Superscalar-HIT-Core/SHIT-Core-NSCSCC2020/src/rtl/CtrlUnitBackend.sv

`timescale 1ns / 1ps
`include "defines/defines.svh"

module CtrlUnitBackend(
    input clk,
    input rst,
    Ctrl.master     backend_ctrl,

    Ctrl.master     ctrl_instBuffer_decode_regs,
    Ctrl.master     ctrl_decode_rename_regs,
    Ctrl.master     ctrl_rob,
    Ctrl.master     ctrl_issue_alu0_regs,
    Ctrl.master     ctrl_issue_alu1_regs,
    Ctrl.master     ctrl_issue_mdu_regs,
    Ctrl.master     ctrl_issue_lsu_regs,
    Ctrl.master     ctrl_rf_alu0_regs,
    Ctrl.master     ctrl_rf_alu1_regs,
    Ctrl.master     ctrl_rf_mdu_regs,
    Ctrl.master     ctrl_rf_lsu_regs,
    Ctrl.master     ctrl_lsu,
    Ctrl.master     ctrl_mdu,
    Ctrl.master     ctrl_alu0_output_regs,
    Ctrl.master     ctrl_alu1_output_regs,
    Ctrl.master     ctrl_mdu_output_regs,
    Ctrl.master     ctrl_lsu_output_regs,
    Ctrl.master     ctrl_commit,

    input wire           aluIQReady,
    input wire           lsuIQReady,
    input wire           mduIQReady,
    input wire           renameAllocatable,
    input wire           dispatch_pause_req,

    output wire           renameRecover,
    output wire           aluIQFlush,
    output wire           lsuIQFlush,
    output wire           mduIQFlush,

    output wire           pauseRename,
    output wire           pauseRename_dispatch_reg,
    output wire           pauseDispatch_iq_reg,
    output wire           pauseDispatch
);

    assign ctrl_instBuffer_decode_regs.pause =
        ctrl_rob.pauseReq                   ||
        ctrl_decode_rename_regs.pauseReq    ||
        !aluIQReady                         ||
        !lsuIQReady                         ||
        !mduIQReady                         ||
        !renameAllocatable                  ||
        dispatch_pause_req;

    assign ctrl_decode_rename_regs.pause =
        ctrl_rob.pauseReq                   ||
        !aluIQReady                         ||
        !lsuIQReady                         ||
        !mduIQReady                         ||
        !renameAllocatable                  ||
        dispatch_pause_req;

    assign pauseRename =
        ctrl_rob.pauseReq                   ||
        !aluIQReady                         ||
        !lsuIQReady                         ||
        !mduIQReady                         ||
        dispatch_pause_req;

    assign pauseRename_dispatch_reg =
        ctrl_rob.pauseReq                   ||
        !aluIQReady                         ||
        !lsuIQReady                         ||
        !mduIQReady                         ||
        dispatch_pause_req;

    assign pauseDispatch =
        ctrl_rob.pauseReq                   ||
        !aluIQReady                         ||
        !lsuIQReady                         ||
        !mduIQReady;

    assign pauseDispatch_iq_reg = 
        !aluIQReady                         ||
        !lsuIQReady                         ||
        !mduIQReady;
    
    reg flushReq_dly;
    always @(posedge clk)   begin
        if(rst) begin
            flushReq_dly <= 0;
        end else begin
            flushReq_dly <= ctrl_commit.flushReq;
        end
    end
    assign  ctrl_instBuffer_decode_regs.flush   = flushReq_dly;
    assign  ctrl_decode_rename_regs.flush       = flushReq_dly;
    assign  ctrl_rob.flush                      = flushReq_dly || ctrl_commit.flushReq;
    assign  ctrl_issue_alu0_regs.flush          = flushReq_dly;
    assign  ctrl_issue_alu1_regs.flush          = flushReq_dly;
    assign  ctrl_issue_lsu_regs.flush           = flushReq_dly;
    assign  ctrl_issue_mdu_regs.flush           = flushReq_dly;
    assign  ctrl_rf_alu0_regs.flush             = flushReq_dly;
    assign  ctrl_rf_alu1_regs.flush             = flushReq_dly;
    assign  ctrl_rf_mdu_regs.flush              = flushReq_dly;
    assign  ctrl_rf_lsu_regs.flush              = flushReq_dly;
    assign  ctrl_alu0_output_regs.flush         = flushReq_dly;
    assign  ctrl_alu1_output_regs.flush         = flushReq_dly;
    assign  ctrl_mdu_output_regs.flush          = flushReq_dly;
    assign  ctrl_mdu.flush                      = flushReq_dly;
    assign  ctrl_lsu_output_regs.flush          = flushReq_dly;
    assign  ctrl_lsu.flush                      = flushReq_dly || ctrl_commit.flushReq;
    assign  aluIQFlush                          = flushReq_dly;
    assign  lsuIQFlush                          = flushReq_dly;
    assign  mduIQFlush                          = flushReq_dly;
    assign  backend_ctrl.flush                  = ctrl_commit.flushReq;
    assign  renameRecover                       = flushReq_dly;
    assign  backend_ctrl.pause                  = `FALSE;

endmodule
