Superscalar-HIT-Core/SHIT-Core-NSCSCC2020/src/rtl/decode.sv

`timescale 1ns / 1ps
`include "defines/defines.svh"


module decode(
    Regs_Decode.decode  regs_decode,
    Decode_Regs.decode  decode_regs
);
    logic   [ 5:0]  opcode;
    logic   [ 5:0]  rs;
    logic   [ 5:0]  rt;
    logic   [ 5:0]  rd;
    logic   [ 5:0]  funct;
    logic   [31:0]  imm;
    logic   [31:0]  imm2;
    logic   [31:0]  imm_ze;
    logic   [31:0]  imm_lui;
    logic   [25:0]  address;
    logic   [31:0]  inst_raw;
    InstBundle      inst;
    UOPBundle       uOP0, uOP1;

    
    assign decode_regs.uOP0 = uOP0;
    assign decode_regs.uOP1 = uOP1;


    assign inst     = regs_decode.inst;
    assign inst_raw = regs_decode.inst.inst;
    assign opcode   = inst_raw[31:26];
    assign rs       = {1'b0, inst_raw[25:21]};
    assign rt       = {1'b0, inst_raw[20:16]};
    assign rd       = {1'b0, inst_raw[15:11]};
    assign funct    = inst_raw[5: 0];
    assign imm      = {{16{inst_raw[15]}}, inst_raw[15: 0]};
    assign imm_ze   = {{16'h0000}, inst_raw[15: 0]};
    assign imm2     = {27'h0, inst_raw[10: 6]};
    assign imm_lui  = { inst_raw[15:0] , 16'b0 };
    assign address  = inst_raw[25: 0];
    // regs_decode.inst: InstBundle

    always_comb begin
        uOP0             = 0;
        uOP1             = 0;
        uOP0.uOP         = NOP_U;
        uOP0.nlpBimState = inst.nlpInfo.valid ? inst.nlpInfo.bimState : 2'b01;
        uOP1.uOP         = NOP_U;
        uOP0.pc          = inst.pc;
        uOP0.predTaken   = inst.predTaken;
        uOP0.predAddr    = inst.predAddr;
        uOP0.predInfo    = inst.bpdInfo;
        uOP0.isDS        = inst.isDs;
        uOP0.committed   = `FALSE;
        uOP1.pc          = inst.pc;
        uOP1.isDS        = inst.isDs;
        uOP1.committed   = `FALSE;
        if(inst.valid) begin
            uOP0.isPriv     = `FALSE;
            uOP0.branchType = typeNormal;
            uOP0.imm        = imm;
            uOP0.valid      = `TRUE;
            uOP1.valid      = `FALSE;
            uOP0.causeExc   = `FALSE;
            priority casez(inst_raw)
                `NOP: begin
                    uOP0.valid      = `FALSE;
                end
                `ADD: begin
                    uOP0.uOP        = ADD_U;
                    uOP0.rs_type    = RS_ALU;
                    uOP0.aluType    = ALU_ARITH;
                    uOP0.op0LAddr   = rs;
                    uOP0.op1LAddr   = rt;
                    uOP0.dstLAddr   = rd;
                    uOP0.op0re      = `TRUE;
                    uOP0.op1re      = `TRUE;
                    uOP0.dstwe      = `TRUE;
                end
                `ADDU: begin
                    uOP0.uOP        = ADDU_U;
                    uOP0.rs_type    = RS_ALU;
                    uOP0.aluType    = ALU_ARITH;
                    uOP0.op0LAddr   = rs;
                    uOP0.op1LAddr   = rt;
                    uOP0.dstLAddr   = rd;
                    uOP0.op0re      = `TRUE;
                    uOP0.op1re      = `TRUE;
                    uOP0.dstwe      = `TRUE;
                end
                `ADDI: begin
                    uOP0.uOP        = ADDI_U;
                    uOP0.rs_type    = RS_ALU;
                    uOP0.aluType    = ALU_ARITH;
                    uOP0.op0LAddr   = rs;
                    uOP0.dstLAddr   = rt;
                    uOP0.op0re      = `TRUE;
                    uOP0.op1re      = `FALSE;
                    uOP0.dstwe      = `TRUE;
                end
                `ADDIU: begin
                    uOP0.uOP        = ADDIU_U;
                    uOP0.rs_type    = RS_ALU;
                    uOP0.aluType    = ALU_ARITH;
                    uOP0.op0LAddr   = rs;
                    uOP0.dstLAddr   = rt;
                    uOP0.op0re      = `TRUE;
                    uOP0.op1re      = `FALSE;
                    uOP0.dstwe      = `TRUE;
                end
                `SUB: begin
                    uOP0.uOP        = SUB_U;
                    uOP0.rs_type    = RS_ALU;
                    uOP0.aluType    = ALU_ARITH;
                    uOP0.op0LAddr   = rs;
                    uOP0.op1LAddr   = rt;
                    uOP0.dstLAddr   = rd;
                    uOP0.op0re      = `TRUE;
                    uOP0.op1re      = `TRUE;
                    uOP0.dstwe      = `TRUE;
                end
                `SUBU: begin
                    uOP0.uOP        = SUBU_U;
                    uOP0.rs_type    = RS_ALU;
                    uOP0.aluType    = ALU_ARITH;
                    uOP0.op0LAddr   = rs;
                    uOP0.op1LAddr   = rt;
                    uOP0.dstLAddr   = rd;
                    uOP0.op0re      = `TRUE;
                    uOP0.op1re      = `TRUE;
                    uOP0.dstwe      = `TRUE;
                end
                `SLT: begin
                    uOP0.uOP        = SLT_U;
                    uOP0.rs_type    = RS_ALU;
                    uOP0.aluType    = ALU_ARITH;
                    uOP0.op0LAddr   = rs;
                    uOP0.op1LAddr   = rt;
                    uOP0.dstLAddr   = rd;
                    uOP0.op0re      = `TRUE;
                    uOP0.op1re      = `TRUE;
                    uOP0.dstwe      = `TRUE;
                end
                `SLTU: begin
                    uOP0.uOP        = SLTU_U;
                    uOP0.rs_type    = RS_ALU;
                    uOP0.aluType    = ALU_ARITH;
                    uOP0.op0LAddr   = rs;
                    uOP0.op1LAddr   = rt;
                    uOP0.dstLAddr   = rd;
                    uOP0.op0re      = `TRUE;
                    uOP0.op1re      = `TRUE;
                    uOP0.dstwe      = `TRUE;
                end
                `SLTI: begin
                    uOP0.uOP        = SLTI_U;
                    uOP0.rs_type    = RS_ALU;
                    uOP0.aluType    = ALU_ARITH;
                    uOP0.op0LAddr   = rs;
                    uOP0.dstLAddr   = rt;
                    uOP0.op0re      = `TRUE;
                    uOP0.op1re      = `FALSE;
                    uOP0.dstwe      = `TRUE;
                end
                `SLTIU: begin
                    uOP0.uOP        = SLTIU_U;
                    uOP0.rs_type    = RS_ALU;
                    uOP0.aluType    = ALU_ARITH;
                    uOP0.op0LAddr   = rs;
                    uOP0.dstLAddr   = rt;
                    uOP0.op0re      = `TRUE;
                    uOP0.op1re      = `FALSE;
                    uOP0.dstwe      = `TRUE;
                end
                `DIV: begin
                    uOP0.uOP        = DIVHI_U;
                    uOP0.rs_type    = RS_MDU;
                    uOP0.op0LAddr   = rs;
                    uOP0.op1LAddr   = rt;
                    uOP0.dstLAddr   = `REGHI;
                    uOP0.op0re      = `TRUE;
                    uOP0.op1re      = `TRUE;
                    uOP0.dstwe      = `TRUE;

                    uOP1.uOP        = DIVLO_U;
                    uOP1.rs_type    = RS_MDU;
                    uOP1.op0LAddr   = rs;
                    uOP1.op1LAddr   = rt;
                    uOP1.dstLAddr   = `REGLO;
                    uOP1.op0re      = `TRUE;
                    uOP1.op1re      = `TRUE;
                    uOP1.dstwe      = `TRUE;
                    uOP1.valid      = `TRUE;
                end
                `DIVU: begin
                    uOP0.uOP        = DIVUHI_U;
                    uOP0.rs_type    = RS_MDU;
                    uOP0.op0LAddr   = rs;
                    uOP0.op1LAddr   = rt;
                    uOP0.dstLAddr   = `REGHI;
                    uOP0.op0re      = `TRUE;
                    uOP0.op1re      = `TRUE;
                    uOP0.dstwe      = `TRUE;

                    uOP1.uOP        = DIVULO_U;
                    uOP1.rs_type    = RS_MDU;
                    uOP1.op0LAddr   = rs;
                    uOP1.op1LAddr   = rt;
                    uOP1.dstLAddr   = `REGLO;
                    uOP1.op0re      = `TRUE;
                    uOP1.op1re      = `TRUE;
                    uOP1.dstwe      = `TRUE;
                    uOP1.valid      = `TRUE;
                end
                `MULT: begin
                    uOP0.uOP        = MULTHI_U;
                    uOP0.rs_type    = RS_MDU;
                    uOP0.op0LAddr   = rs;
                    uOP0.op1LAddr   = rt;
                    uOP0.dstLAddr   = `REGHI;
                    uOP0.op0re      = `TRUE;
                    uOP0.op1re      = `TRUE;
                    uOP0.dstwe      = `TRUE;

                    uOP1.uOP        = MULTLO_U;
                    uOP1.rs_type    = RS_MDU;
                    uOP1.op0LAddr   = rs;
                    uOP1.op1LAddr   = rt;
                    uOP1.dstLAddr   = `REGLO;
                    uOP1.op0re      = `TRUE;
                    uOP1.op1re      = `TRUE;
                    uOP1.dstwe      = `TRUE;
                    uOP1.valid      = `TRUE;
                end
                `MULTU: begin
                    uOP0.uOP        = MULTUHI_U;
                    uOP0.rs_type    = RS_MDU;
                    uOP0.op0LAddr   = rs;
                    uOP0.op1LAddr   = rt;
                    uOP0.dstLAddr   = `REGHI;
                    uOP0.op0re      = `TRUE;
                    uOP0.op1re      = `TRUE;
                    uOP0.dstwe      = `TRUE;

                    uOP1.uOP        = MULTULO_U;
                    uOP1.rs_type    = RS_MDU;
                    uOP1.op0LAddr   = rs;
                    uOP1.op1LAddr   = rt;
                    uOP1.dstLAddr   = `REGLO;
                    uOP1.op0re      = `TRUE;
                    uOP1.op1re      = `TRUE;
                    uOP1.dstwe      = `TRUE;
                    uOP1.valid      = `TRUE;
                end
                `MUL: begin
                    uOP0.uOP        = MULTHI_U;
                    uOP0.rs_type    = RS_MDU;
                    uOP0.op0LAddr   = rs;
                    uOP0.op1LAddr   = rt;
                    uOP0.dstLAddr   = 0;    // discard high 32
                    uOP0.op0re      = `TRUE;
                    uOP0.op1re      = `TRUE;
                    uOP0.dstwe      = `FALSE;

                    uOP1.uOP        = MULTLO_U;
                    uOP1.rs_type    = RS_MDU;
                    uOP1.op0LAddr   = rs;
                    uOP1.op1LAddr   = rt;
                    uOP1.dstLAddr   = rd;
                    uOP1.op0re      = `TRUE;
                    uOP1.op1re      = `TRUE;
                    uOP1.dstwe      = `TRUE;
                    uOP1.valid      = `TRUE;
                end
                `AND: begin
                    uOP0.uOP        = AND_U;
                    uOP0.rs_type    = RS_ALU;
                    uOP0.aluType    = ALU_LOGIC;
                    uOP0.op0LAddr   = rs;
                    uOP0.op1LAddr   = rt;
                    uOP0.dstLAddr   = rd;
                    uOP0.op0re      = `TRUE;
                    uOP0.op1re      = `TRUE;
                    uOP0.dstwe      = `TRUE;
                end
                `ANDI: begin
                    uOP0.uOP        = ANDI_U;
                    uOP0.rs_type    = RS_ALU;
                    uOP0.aluType    = ALU_LOGIC;
                    uOP0.op0LAddr   = rs;
                    uOP0.dstLAddr   = rt;
                    uOP0.op0re      = `TRUE;
                    uOP0.op1re      = `FALSE;
                    uOP0.dstwe      = `TRUE;
                    uOP0.imm        = imm_ze;
                end
                `OR: begin
                    uOP0.uOP        = OR_U;
                    uOP0.rs_type    = RS_ALU;
                    uOP0.aluType    = ALU_LOGIC;
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
                    uOP0.isPriv     = `TRUE;
                    uOP0.cp0Addr    = rd;
                    uOP0.cp0Sel     = inst[2:0];
                end
                `MTC0: begin
                    uOP0.uOP        = MTC0_U;
                    uOP0.rs_type    = RS_ALU;
                    uOP0.aluType    = ALU_CP0;
                    uOP0.op0LAddr   = rt;
                    uOP0.op0re      = `TRUE;
                    uOP0.op1re      = `FALSE;
                    uOP0.dstwe      = `FALSE;
                    uOP0.isPriv     = `TRUE;
                    uOP0.cp0Addr    = rd;
                    uOP0.cp0Sel     = inst[2:0];
                end
                `TLBP: begin
                    uOP0.uOP        = TLBP_U;
                    uOP0.rs_type    = RS_ALU;
                    uOP0.aluType    = ALU_MISC;
                    uOP0.op0re      = `FALSE;
                    uOP0.op1re      = `FALSE;
                    uOP0.dstwe      = `FALSE;
                    uOP0.isPriv     = `TRUE;
                    uOP0.cp0Addr    = `CP0INDEX;
                end
                `TLBWI: begin
                    uOP0.uOP        = TLBP_U;
                    uOP0.rs_type    = RS_ALU;
                    uOP0.aluType    = ALU_MISC;
                    uOP0.op0re      = `FALSE;
                    uOP0.op1re      = `FALSE;
                    uOP0.dstwe      = `FALSE;
                    uOP0.isPriv     = `TRUE;
                    // use multiple cp0 reg (EntryHi, EntryLo0, EntryLo1)
                end
                `CACHE: begin
                    uOP0.uOP        = CACHE_U;
                    uOP0.rs_type    = RS_ALU;
                    uOP0.aluType    = ALU_MISC;
                    uOP0.op0LAddr   = rs;
                    uOP0.op0re      = `TRUE;
                    uOP0.op1re      = `FALSE;
                    uOP0.dstwe      = `FALSE;
                    uOP0.cacheOP    = inst[16:10];
                end
                `WAIT: begin    // must be priv
                    uOP0.uOP        = WAIT_U;
                    uOP0.rs_type    = RS_ALU;
                    uOP0.aluType    = ALU_MISC;
                    uOP0.op0re      = `FALSE;
                    uOP0.op1re      = `FALSE;
                    uOP0.dstwe      = `FALSE;
                    uOP0.isPriv     = `TRUE;
                end
                default: begin
                    uOP0.uOP        = RESERVED_U;
                    uOP0.rs_type    = RS_ALU;
                    uOP0.aluType    = ALU_MISC;
                    uOP0.op0re      = `FALSE;
                    uOP0.op1re      = `FALSE;
                    uOP0.dstwe      = `FALSE;
                    uOP0.busy       = `FALSE;
                    uOP0.valid      = `TRUE;
                    uOP0.causeExc   = `TRUE;
                    uOP0.exception  = ExcReservedInst;
                end
            endcase
            // inst fetch bad vaddr, high priority
            if(inst.jBadAddr) begin
                uOP0.causeExc       = `TRUE;
                uOP0.exception      = ExcAddressErrIF;
                uOP0.BadVAddr       = inst.predAddr;    // wont trigger on Jr, only when predecode get wrong addr
            end
        end else begin
            uOP0.valid      = `FALSE;
            uOP1.valid      = `FALSE;
        end
    end

endmodule
