Superscalar-HIT-Core/SHIT-Core-NSCSCC2020/src/rtl/exu/prf.sv

`timescale 1ns / 1ps
`include "../defines/defines.svh"
//////////////////////////////////////////////////////////////////////////////////
// 物理寄存器堆文件
//////////////////////////////////////////////////////////////////////////////////

module prf(
    input clk,
    input rst,
    input PRFrNums rnum_ALU_0, rnum_ALU_1, rnum_MDU, rnum_LSU,
    output PRFrData rdata_ALU_0, rdata_ALU_1, rdata_MDU, rdata_LSU,
    input PRFwInfo wb_ALU_0, wb_ALU_1, wb_MDU, wb_LSU
    );
// 4 Banks of prf
reg [31:0] prfs_bank0[63:0];
reg [31:0] prfs_bank1[63:0];
reg [31:0] prfs_bank2[63:0];
reg [31:0] prfs_bank3[63:0];



// Implement Bypass logic
assign rdata_ALU_0.rs0_data =   ( rnum_ALU_0.rs0 == 0 ) ? 32'b0 : 
                                ( (rnum_ALU_0.rs0 == wb_ALU_0.rd) && wb_ALU_0.wen) ? wb_ALU_0.wdata :
                                ( (rnum_ALU_0.rs0 == wb_ALU_1.rd) && wb_ALU_1.wen) ? wb_ALU_1.wdata :
                                ( (rnum_ALU_0.rs0 == wb_MDU.rd) && wb_MDU.wen) ? wb_MDU.wdata :
                                ( (rnum_ALU_0.rs0 == wb_LSU.rd) && wb_LSU.wen) ? wb_LSU.wdata : prfs_bank0[rnum_ALU_0.rs0];

assign rdata_ALU_0.rs1_data =   ( rnum_ALU_0.rs1 == 0 ) ? 32'b0 : 
                                ( (rnum_ALU_0.rs1 == wb_ALU_0.rd) && wb_ALU_0.wen) ? wb_ALU_0.wdata :
                                ( (rnum_ALU_0.rs1 == wb_ALU_1.rd) && wb_ALU_1.wen) ? wb_ALU_1.wdata :
                                ( (rnum_ALU_0.rs1 == wb_MDU.rd) && wb_MDU.wen) ? wb_MDU.wdata :
                                ( (rnum_ALU_0.rs1 == wb_LSU.rd) && wb_LSU.wen) ? wb_LSU.wdata : prfs_bank0[rnum_ALU_0.rs1];

assign rdata_ALU_1.rs0_data =   ( rnum_ALU_1.rs0 == 0 ) ? 32'b0 : 
                                ( (rnum_ALU_1.rs0 == wb_ALU_0.rd) && wb_ALU_0.wen) ? wb_ALU_0.wdata :
                                ( (rnum_ALU_1.rs0 == wb_ALU_1.rd) && wb_ALU_1.wen) ? wb_ALU_1.wdata :
                                ( (rnum_ALU_1.rs0 == wb_MDU.rd) && wb_MDU.wen) ? wb_MDU.wdata :
                                ( (rnum_ALU_1.rs0 == wb_LSU.rd) && wb_LSU.wen) ? wb_LSU.wdata : prfs_bank1[rnum_ALU_1.rs0];

assign rdata_ALU_1.rs1_data =   ( rnum_ALU_1.rs1 == 0 ) ? 32'b0 : 
                                ( (rnum_ALU_1.rs1 == wb_ALU_0.rd) && wb_ALU_0.wen) ? wb_ALU_0.wdata :
                                ( (rnum_ALU_1.rs1 == wb_ALU_1.rd) && wb_ALU_1.wen) ? wb_ALU_1.wdata :
                                ( (rnum_ALU_1.rs1 == wb_MDU.rd) && wb_MDU.wen) ? wb_MDU.wdata :
                                ( (rnum_ALU_1.rs1 == wb_LSU.rd) && wb_LSU.wen) ? wb_LSU.wdata : prfs_bank1[rnum_ALU_1.rs1];

assign rdata_MDU.rs0_data =     ( rnum_MDU.rs0 == 0 ) ? 32'b0 : 
                                ( (rnum_MDU.rs0 == wb_ALU_0.rd) && wb_ALU_0.wen) ? wb_ALU_0.wdata :
                                ( (rnum_MDU.rs0 == wb_ALU_1.rd) && wb_ALU_1.wen) ? wb_ALU_1.wdata :
                                ( (rnum_MDU.rs0 == wb_MDU.rd) && wb_MDU.wen) ? wb_MDU.wdata :
                                ( (rnum_MDU.rs0 == wb_LSU.rd) && wb_LSU.wen) ? wb_LSU.wdata : prfs_bank2[rnum_MDU.rs0];

assign rdata_MDU.rs1_data =     ( rnum_MDU.rs1 == 0 ) ? 32'b0 : 
                                ( (rnum_MDU.rs1 == wb_ALU_0.rd) && wb_ALU_0.wen) ? wb_ALU_0.wdata :
                                ( (rnum_MDU.rs1 == wb_ALU_1.rd) && wb_ALU_1.wen) ? wb_ALU_1.wdata :
                                ( (rnum_MDU.rs1 == wb_MDU.rd) && wb_MDU.wen) ? wb_MDU.wdata :
                                ( (rnum_MDU.rs1 == wb_LSU.rd) && wb_LSU.wen) ? wb_LSU.wdata : prfs_bank2[rnum_MDU.rs1];

assign rdata_LSU.rs0_data =     ( rnum_LSU.rs0 == 0 ) ? 32'b0 : 
                                ( (rnum_LSU.rs0 == wb_ALU_0.rd) && wb_ALU_0.wen) ? wb_ALU_0.wdata :
                                ( (rnum_LSU.rs0 == wb_ALU_1.rd) && wb_ALU_1.wen) ? wb_ALU_1.wdata :
                                ( (rnum_LSU.rs0 == wb_MDU.rd) && wb_MDU.wen) ? wb_MDU.wdata :
                                ( (rnum_LSU.rs0 == wb_LSU.rd) && wb_LSU.wen) ? wb_LSU.wdata : prfs_bank3[rnum_LSU.rs0];

assign rdata_LSU.rs1_data =     ( rnum_LSU.rs1 == 0 ) ? 32'b0 : 
                                ( (rnum_LSU.rs1 == wb_ALU_0.rd) && wb_ALU_0.wen) ? wb_ALU_0.wdata :
                                ( (rnum_LSU.rs1 == wb_ALU_1.rd) && wb_ALU_1.wen) ? wb_ALU_1.wdata :
                                ( (rnum_LSU.rs1 == wb_MDU.rd) && wb_MDU.wen) ? wb_MDU.wdata :
                                ( (rnum_LSU.rs1 == wb_LSU.rd) && wb_LSU.wen) ? wb_LSU.wdata : prfs_bank3[rnum_LSU.rs1];


integer i;
always_ff @(posedge clk)    begin
    if(rst) begin
        for(i=0;i<64;i++)   begin
            prfs_bank0[i] <= 32'b0;
            prfs_bank1[i] <= 32'b0;
            prfs_bank2[i] <= 32'b0;
            prfs_bank3[i] <= 32'b0;
        end
    end else begin
        if(wb_ALU_0.wen) begin
            prfs_bank0[wb_ALU_0.rd] <= wb_ALU_0.wdata;
            prfs_bank1[wb_ALU_0.rd] <= wb_ALU_0.wdata;
            prfs_bank2[wb_ALU_0.rd] <= wb_ALU_0.wdata;
            prfs_bank3[wb_ALU_0.rd] <= wb_ALU_0.wdata;
        end
        if(wb_ALU_1.wen) begin
            prfs_bank0[wb_ALU_1.rd] <= wb_ALU_1.wdata;
            prfs_bank1[wb_ALU_1.rd] <= wb_ALU_1.wdata;
            prfs_bank2[wb_ALU_1.rd] <= wb_ALU_1.wdata;
            prfs_bank3[wb_ALU_1.rd] <= wb_ALU_1.wdata;
        end
        if(wb_MDU.wen) begin
            prfs_bank0[wb_MDU.rd] <= wb_MDU.wdata;
            prfs_bank1[wb_MDU.rd] <= wb_MDU.wdata;
            prfs_bank2[wb_MDU.rd] <= wb_MDU.wdata;
            prfs_bank3[wb_MDU.rd] <= wb_MDU.wdata;
        end
        if(wb_LSU.wen) begin
            prfs_bank0[wb_LSU.rd] <= wb_LSU.wdata;
            prfs_bank1[wb_LSU.rd] <= wb_LSU.wdata;
            prfs_bank2[wb_LSU.rd] <= wb_LSU.wdata;
            prfs_bank3[wb_LSU.rd] <= wb_LSU.wdata;
        end
    end
end
// synopsys translate_off
always_ff @ (posedge clk) begin
    // if(wb_ALU_0.wen) $display("WB info from alu0: %d <= %d", wb_ALU_0.rd, wb_ALU_0.wdata);
    // if(wb_ALU_1.wen) $display("WB info from alu1: %d <= %d", wb_ALU_1.rd, wb_ALU_1.wdata);
    // if(wb_LSU.wen) $display("WB info from lsu: %d <= %d", wb_LSU.rd, wb_LSU.wdata);
    // if(wb_MDU.wen) $display("WB info from mdu: %d <= %d", wb_MDU.rd, wb_MDU.wdata);
end
// synopsys translate_on

endmodule
