Superscalar-HIT-Core/SHIT-Core-NSCSCC2020/src/rtl/ifu/Predecoder.sv

`timescale 1ns / 1ps
`include "../defs.sv"
`include "../defines/defines.svh"

module Predecoder(
    input   logic [31:0]    pc,
    input   logic [31:0]    inst,
    input   logic           valid,
    output  logic           isJ,
    output  logic           isBr,
    output  logic           jr,
    output  logic           isLink,
    output  logic           isReturn,
    output  logic [31:0]    target
);

    always_comb begin
        isJ     = `FALSE;
        isBr    = `FALSE;
        jr      = `FALSE;
        target  = 0;
        if(valid) begin
            casez (inst)
                // quick redirect
                `J, `JAL: begin
                    isJ     = `TRUE;    // must redirect
                    isBr    = `FALSE;
                    jr      = `FALSE;
                    target  = {pc[31:28], inst[25:0], 2'b00};
                end
                `BAL, `B: begin  // BAL
                    isJ     = `TRUE;    // must redirect, with different address
                    isBr    = `FALSE;
                    jr      = `FALSE;
                    target  = pc + {{14{inst[15]}}, inst[15:0], 2'b00} + 4;
                end
                // backend-redirect, predecode for wrong target or checking NLP/BPD false postive(br/normal mispredict)
                `BEQ, `BNE, `BGEZ, `BGEZAL, `BGTZ, `BLEZ, `BLTZ, `BLTZAL: begin
                    isJ     = `FALSE;  // redirect unknown;
                    isBr    = `TRUE;
                    jr      = `FALSE;
                    target  = pc + {{14{inst[15]}}, inst[15:0], 2'b00} + 4;
                end
                `JR, `JALR: begin  // JALR
                    isJ     = `TRUE;
                    isBr    = `FALSE;
                    jr      = `TRUE;    // must redirect, unless unknown target info
                    target  = 32'h00000000;
                end
                default: begin
                    isJ     = `FALSE;
                    isBr    = `FALSE;
                    jr      = `FALSE;   // don't redirect on normal instrutions
                    target  = 32'h00000000;
                end
            endcase
        end
    end

    always_comb begin
        isLink = `FALSE;
        if(valid) begin
            casez (inst)
                // quick redirect
                `JAL,`BGEZAL, `BLTZAL: begin
                    isLink = `TRUE;
                end
                `JALR:  begin
                    if(inst[15:11] == 5'h1f) isLink = `TRUE;
                end
                default: begin
                    isLink = `FALSE;
                end
            endcase
        end
    end

    always_comb begin
        isReturn = `FALSE;
        if(valid) begin
            casez (inst)
                // quick redirect
                `JR, `JALR: begin
                    if(inst[25:21] == 5'h1f) isReturn = `TRUE;
                end
                default: begin
                    isReturn = `FALSE;
                end
            endcase
        end
    end

endmodule
