Superscalar-HIT-Core/SHIT-Core-NSCSCC2020/src/rtl/LSU/uncache_handler.sv

`timescale 1ns / 1ps
`include "LSU_defines.svh"
module uncache_handler(
    GLOBAL.slave                g,
    WBUFFER2UHANDLER.uhandler   wb2uh,
    RBUFFER2UHANDLER.uhandler   rb2uh,
    UNCACHE2MEMORY.lsu          uc2mem
    );

    logic rbusy;
    logic rready = 1'b1;
    assign rb2uh.uready = uc2mem.mready & ~rbusy;
    
    always_ff @(posedge g.clk)
        if(!g.resetn)
            rbusy <= 1'b0;
        else if(rb2uh.rvalid & rb2uh.uready)
            rbusy <= 1'b1;
        else if(rb2uh.uvalid & rb2uh.rready)
            rbusy <= 1'b0;

    logic [1:0] raddr_reg;
    always @(posedge g.clk) if(rb2uh.rvalid & rb2uh.uready) raddr_reg <= rb2uh.raddr[1:0];

    assign wb2uh.ready = rb2uh.uready & ~rb2uh.rvalid;

    assign uc2mem.uvalid = rb2uh.rvalid | wb2uh.w;
    assign uc2mem.uwen = wb2uh.w & ~rb2uh.rvalid;
    assign uc2mem.uaddr = rb2uh.rvalid ? rb2uh.raddr : wb2uh.waddr;
    
    always_comb
        case(wb2uh.size)
        s_word: uc2mem.udata = wb2uh.data;
        s_half: case(wb2uh.waddr[1])
                1'b0: uc2mem.udata = {16'bx,wb2uh.data[15:0]};
                1'b1: uc2mem.udata = {wb2uh.data[15:0],16'bx};
                endcase
        s_byte: case(wb2uh.waddr[1:0])
                2'b00: uc2mem.udata = {24'bx,wb2uh.data[7:0]};
                2'b01: uc2mem.udata = {16'bx,wb2uh.data[7:0],8'bx};
                2'b10: uc2mem.udata = {8'bx,wb2uh.data[7:0],16'bx};
                2'b11: uc2mem.udata = {wb2uh.data[7:0],24'bx};
                endcase
        endcase
    assign uc2mem.uready = rb2uh.rready;

    always_comb
        if(rb2uh.rvalid)
            case(rb2uh.rsize)
            s_word: uc2mem.usize = 3'b010;
            s_half: uc2mem.usize = 3'b001;
            s_byte: uc2mem.usize = 3'b000;
            default: uc2mem.usize = 3'bxxx;
            endcase
        else if(wb2uh.w)
            case(wb2uh.size)
            s_word: uc2mem.usize = 3'b010;
            s_half: uc2mem.usize = 3'b001;
            s_byte: uc2mem.usize = 3'b000;
            default: uc2mem.usize = 3'bxxx;
            endcase
        else 
            uc2mem.usize = 3'bxxx;
    always_comb 
        case(wb2uh.size)
        s_word: uc2mem.ustrobe = 4'hf;
        s_half: 
            case(wb2uh.waddr[1])
            1'b0: uc2mem.ustrobe = 4'h3;
            1'b1: uc2mem.ustrobe = 4'hc;
            endcase
        s_byte:
            case(wb2uh.waddr[1:0])
            2'b00: uc2mem.ustrobe = 4'h1;
            2'b01: uc2mem.ustrobe = 4'h2;
            2'b10: uc2mem.ustrobe = 4'h4;
            2'b11: uc2mem.ustrobe = 4'h8;
            endcase
        default: uc2mem.ustrobe = 4'hx;
        endcase

    always_ff @(posedge g.clk)
        if(!g.resetn)
            rb2uh.uvalid <= 1'b0;
        else if(uc2mem.mvalid)
            rb2uh.uvalid <= 1'b1;
        else if(rb2uh.rready)
            rb2uh.uvalid <= 1'b0;

    always_ff @(posedge g.clk) rb2uh.udata <= uc2mem.mdata >> {raddr_reg,3'b0};
//    always_ff @(posedge g.clk) rb2uh.udata <= uc2mem.mdata;
endmodule
