Superscalar-HIT-Core/SHIT-Core-NSCSCC2020/src/rtl/decode_rename_regs.sv

`timescale 1ns / 1ps
`include "defines/defines.svh"

module decode_rename_regs(
    input   wire        clk,
    input   wire        rst,

    Ctrl.slave          ctrl_decode_rename_regs,

    Decode_Regs.regs    decode0_regs,
    Decode_Regs.regs    decode1_regs,

    Regs_Rename.regs    regs_rename
);

    logic       full;
    logic       lastIsFull;
    UOPBundle   uOP0, uOP1, uOP2, uOP3;

    assign full = (uOP1.valid || uOP3.valid) && !lastIsFull;
    assign ctrl_decode_rename_regs.pauseReq = full;
    
    always_ff @ (posedge clk) begin
        if(rst || ctrl_decode_rename_regs.flush) begin
            uOP0        <= 0;
            uOP1        <= 0;
            uOP2        <= 0;
            uOP3        <= 0;
            lastIsFull  <= `FALSE;
        end else if(ctrl_decode_rename_regs.pause || full) begin
            uOP0        <= uOP0;
            uOP1        <= uOP1;
            uOP2        <= uOP2;
            uOP3        <= uOP3;
            if(ctrl_decode_rename_regs.pause) begin
                lastIsFull <= lastIsFull;
            end else begin
                lastIsFull <= lastIsFull || full;
            end
        end else begin
            uOP0        <= decode0_regs.uOP0;
            uOP1        <= decode0_regs.uOP1;
            uOP2        <= decode1_regs.uOP0;
            uOP3        <= decode1_regs.uOP1;
            lastIsFull  <= full;
        end
    end

    always_comb begin
        regs_rename.uOP0 = 0;
        regs_rename.uOP1 = 0;
        if(lastIsFull) begin
            regs_rename.uOP0  = uOP2;
            regs_rename.uOP1  = uOP3;
        end else if(full) begin
            regs_rename.uOP0  = uOP0;
            if(uOP1.valid) begin
                regs_rename.uOP1 = uOP1;
            end else begin
                regs_rename.uOP1.uOP        = MDBUBBLE_U;
                // regs_rename.uOP1.isDS       = uOP2.isDS;
                regs_rename.uOP1.pc         = uOP2.pc;
                regs_rename.uOP1.isPriv     = `FALSE;
                regs_rename.uOP1.branchType = typeNormal;
                regs_rename.uOP1.causeExc   = `FALSE;
                regs_rename.uOP1.valid      = `TRUE;
                regs_rename.uOP1.dstwe      = `FALSE;
                regs_rename.uOP1.busy       = `FALSE;
            end
        end else begin
            regs_rename.uOP0  = uOP0;
            regs_rename.uOP1  = uOP2;
        end
    end

endmodule
