Superscalar-HIT-Core/SHIT-Core-NSCSCC2020/src/rtl/rename_dispatch_reg.sv

`timescale 1ns / 1ps
`include "defines/defines.svh"
module rename_dispatch_reg(
    input clk,
    input rst,
    input UOPBundle inst0_in, inst1_in,
    output UOPBundle inst0_out, inst1_out,
    input flush,
    input pauseRename_dispatch_reg
    );

always @(posedge clk)   begin
    if( rst || flush ) begin
        inst0_out <= 0;
        inst1_out <= 0;
    end else if(pauseRename_dispatch_reg) begin
        inst0_out <= inst0_out;
        inst1_out <= inst1_out;
    end else begin
        inst0_out <= inst0_in;
        inst1_out <= inst1_in;
    end
end

endmodule
