Superscalar-HIT-Core/SHIT-Core-NSCSCC2020/(commit log)

2020-07-08 prototype iq
2020-07-11 永远不分配0号寄存器
2020-07-11 重构重命名部分
2020-07-11 队列仿真
2020-07-11 指令重命名测试通过
2020-07-11 修改commit信息的结构，添加valid信号
2020-07-11 fix the physical reg 0 allocation
    [free_list.sv]
2020-07-11 更新进度
2020-07-12 发射仲裁器
2020-07-15 规范Busy Table内部接口信号的命名
2020-07-15 降低encoder层数
2020-07-15 free list的另一种实现方案（注释）
2020-07-15 调整目录层级
2020-07-15 hilo也会被重命名，所以不用单独设置端口了
2020-07-15 34个物理寄存器
2020-07-16 alu inst ops删除
2020-07-16 去除ALU Inst Ops
2020-07-16 ALU Queue基本仲裁发射测试通过
2020-07-16 初步完成唤醒和发射的逻辑
2020-07-16 ALU框架,尚未实现
2020-07-17 decode op改为enum
2020-07-17 修复重复定义的问题
2020-07-17 修改寄存器重命名的顶层封装，以助于直接连接
2020-07-17 TODO: 修改本次提交文件的IQ_ENTRY等定义，部分文件还是和ALU的一样
2020-07-18 backend test driver
2020-07-18 技术性调整
2020-07-18 优化逻辑
2020-07-18 消去无用的注释
2020-07-18 目录结构调整
2020-07-19 :tada: ALU issue / wake passed :memo: Next: Issue flowthrough logic
    [dispatch.sv, issue_unit_ALU.sv, issue_unit_MDU.sv]
2020-07-19 :tada: LSU Queue测试通过 由于无旁路，延迟唤醒LSU
2020-07-20 完成ALU队列改造，监听Busy list
2020-07-20 为每个发射队列建立Scoreboard, 在dispatch阶段写busy table
2020-07-21 缩进调整，LSU添加Scoreboard读端口
2020-07-21 fixed unconnected port error
    [issue_unit_ALU.sv, issue_unit_LSU.sv]
2020-07-21 MDU valid vector fix
    [issue_unit_MDU.sv]
2020-07-22 reset the whole register instead of the valid
    [FU_Output_regs.sv, Issue_RF_regs.sv, MDU.sv, MDUIQ_RF_regs.sv, RF_FU_regs.sv, RF_MDU_regs.sv]
2020-07-22 TODO: Set branch direction and targer resolved
    [FU_Output_regs.sv]
2020-07-22 reset the whole register
    [MDU.sv]
2020-07-22 remove unused logic, enable reset
    [MDU.sv]
2020-07-22 :bug: fixed the pause request
    [CtrlUnitBackend.sv, instBuffer_decode_regs.sv]
2020-07-22 :bug: fixed big bug(ROB ID)
    [dispatch.sv]
2020-07-22 Add pipe stage
2020-07-23 🐛 只有预测跳转的时候，才需要检查地址
2020-07-23 :tada: flush信号应该为2周期恢复
2020-07-23 issue queue lsu fixed
    [issue_unit_LSU.sv]
2020-07-23 🤔 add cp0 dispatch logic, not tested
2020-07-24 pushing through function test. current @ 9fc00d54.
2020-07-24 ✨ 加入特权指令发射判断（串行模式）
2020-07-24 ✨ Add cp0 support, untested
2020-07-24 pushing through function test current @ 0xbfc497a0
2020-07-25 完成CP0和异常
2020-07-25 合并exception模块到commit中
2020-07-25 refactor ICache. current @ 0xbfc00d5c
2020-07-25 pushing through func test. current @ bfc3718c, n58
2020-07-25 pushing through func test. current@bfc3870c, 58/89
2020-07-26 修改ROB中的Exception和BadVAddr字段
2020-07-27 pushing through func test. current bfc015b0, 69/89
2020-07-27 fix a little bug on cp0 inst
    [CP0.sv, dispatch.sv]
2020-07-27 pushing through func test. current 88/89
2020-07-28 replace ternary inside always_ff with if-else
    [CP0.sv, Commit.sv, MDU.sv]
2020-07-28 HUGE bug fix 万恶之源
2020-07-30 Fix iCache edge cases
    [CP0.sv, ICache.sv, MyCPU.sv]
2020-07-30 fix decode_rename_regs edge case
    [decode_rename_regs.sv]
2020-08-02 Fix stupid axi bug
    [AXIInterface.sv]
2020-08-03 fix bug introduced by previous axi fix
    [AXIInterface.sv, MyCPU.sv]
2020-08-04 Add mul, iCache bug fix
    [ICache.sv, decode.sv]
2020-08-05 with mtc0 in delay slot bug
    [BTB.sv, CtrlUnit.sv, IFU.sv, IF_3.sv, MyCPU.sv, branch_predict.sv, dispatch.sv, global_hist.sv]
